wyojustin/DryBoxU1/stl/latch_saddle_qty=2.stl

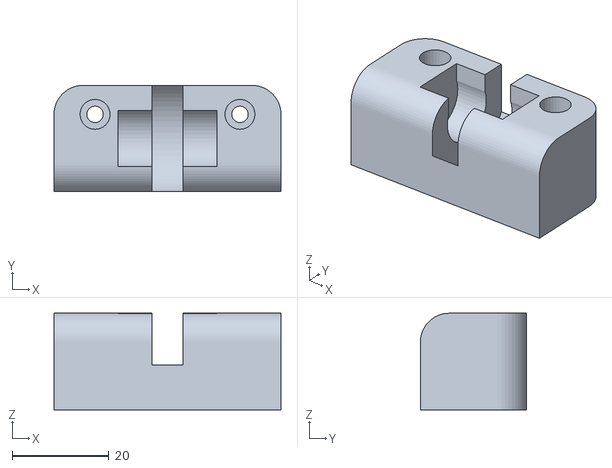
[picture p9: CAD file, 2026-11-11]
stl/latch_saddle_qty=2.stl
47.0 x 22.0 x 20.0
