wyojustin/DryBoxU1/stl/bar_end_cap_qty=2.stl

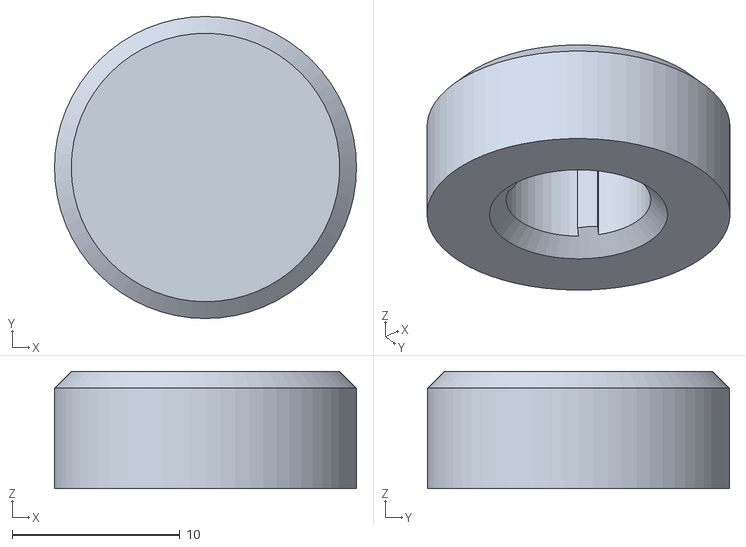
[picture p10: CAD file, 2026-11-11]
stl/bar_end_cap_qty=2.stl
18.0 x 18.0 x 7.00
