wyojustin/DryBoxU1/stl/door_catch_qty=2.stl

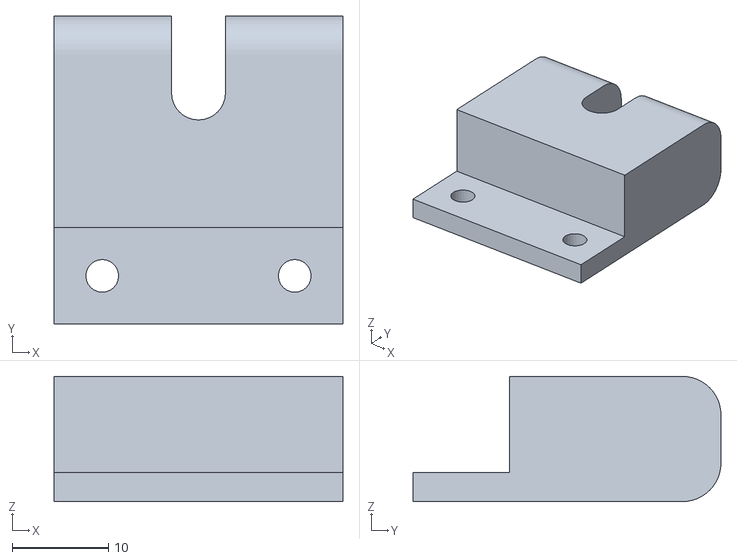
[picture p11: CAD file, 2026-11-11]
stl/door_catch_qty=2.stl
30.0 x 32.0 x 13.0
