wyojustin/DryBoxU1/stl/roller_qty=8.stl

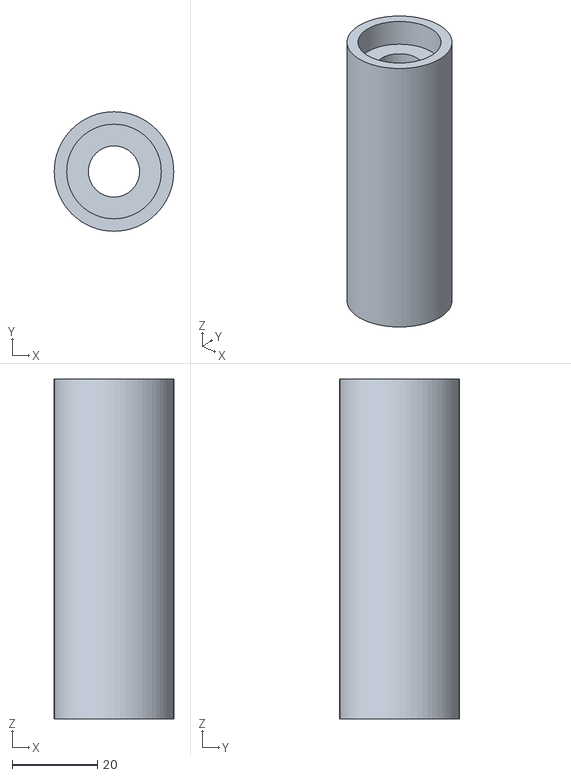
[picture p12: CAD file, 2026-11-07]
stl/roller_qty=8.stl
28.0 x 28.0 x 79.6
