wyojustin/DryBoxU1/stl/hinge_ring_qty=2.stl

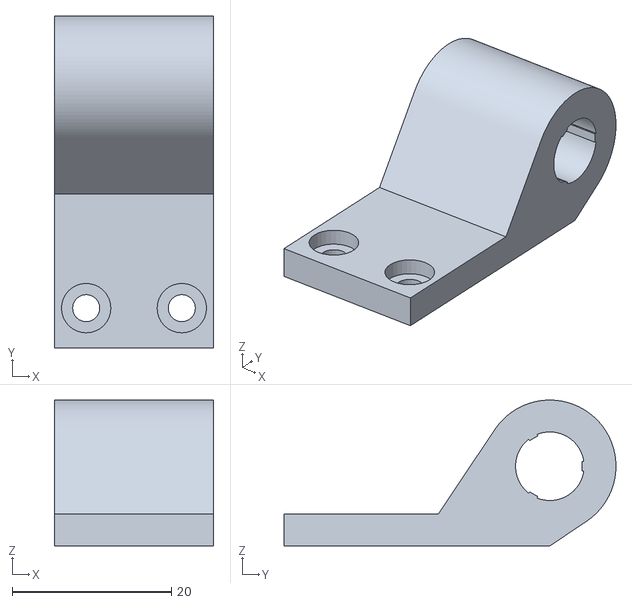
[picture p13: CAD file, 2026-11-07]
stl/hinge_ring_qty=2.stl
20.0 x 41.6 x 18.3
