wyojustin/DryBoxU1/stl/rod_end_cap_qty=8.stl

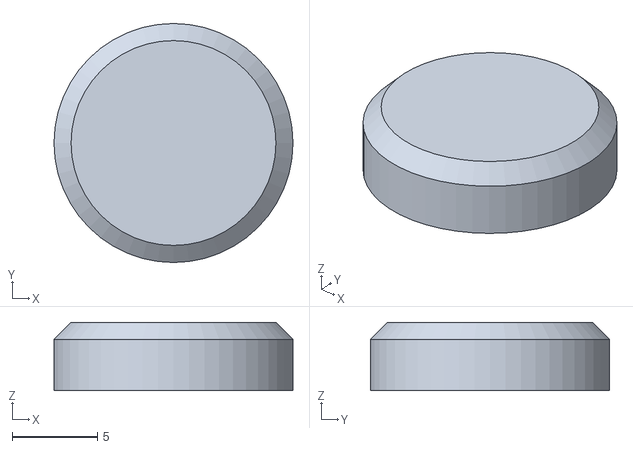
[picture p14: CAD file, 2026-11-07]
stl/rod_end_cap_qty=8.stl
14.0 x 14.0 x 4.00
