wyojustin/DryBoxU1/stl/2026-11-03_swing_latch_saddle.stl

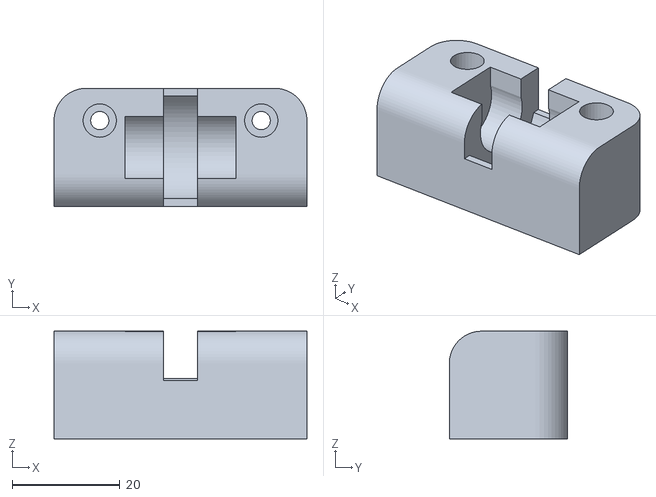
[picture p15: CAD file, 2026-11-07]
stl/2026-11-03_swing_latch_saddle.stl
47.0 x 22.0 x 20.0
