wyojustin/DryBoxU1/stl/latch_barrel_qty=2.stl

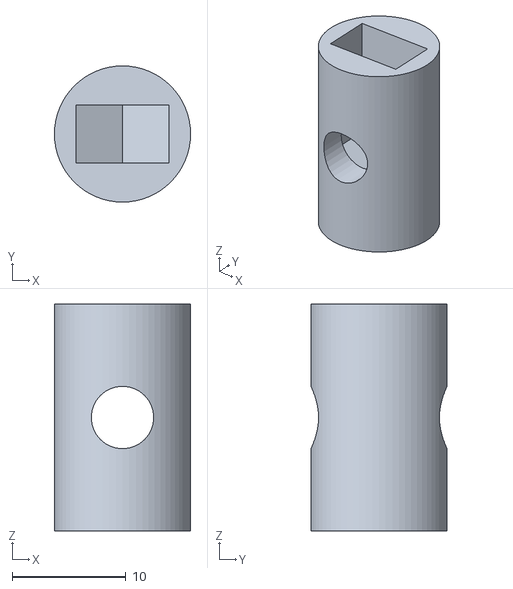
[picture p16: CAD file, 2026-11-07]
stl/latch_barrel_qty=2.stl
12.0 x 12.0 x 20.0
