wyojustin/DryBoxU1/stl/door_handle_qty=1.stl

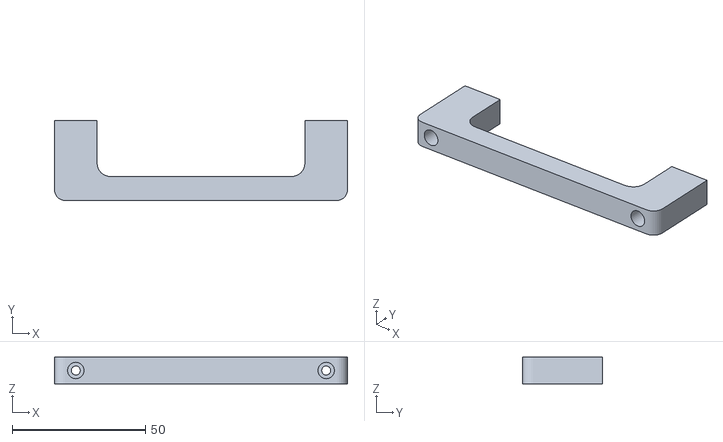
[picture p17: CAD file, 2026-11-07]
stl/door_handle_qty=1.stl
110.0 x 30.0 x 10.0
