wyojustin/DryBoxU1/stl/corner_bracket_qty=4.stl

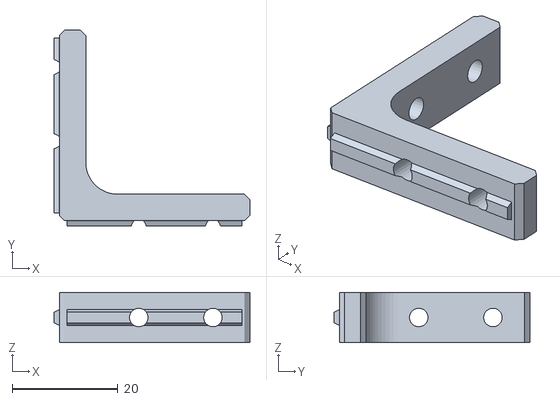
[picture p18: CAD file, 2026-11-07]
stl/corner_bracket_qty=4.stl
37.0 x 37.0 x 9.50
