wyojustin/DryBoxU1/stl/hinge_loop_qty=2.stl

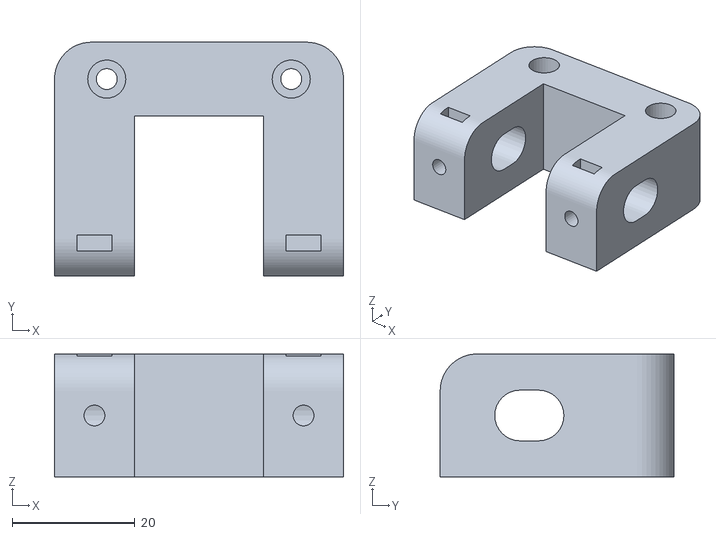
[picture p19: CAD file, 2026-11-07]
stl/hinge_loop_qty=2.stl
47.0 x 38.0 x 20.0
