wyojustin/DryBoxU1/stl/feeder_insert_qty=2.stl

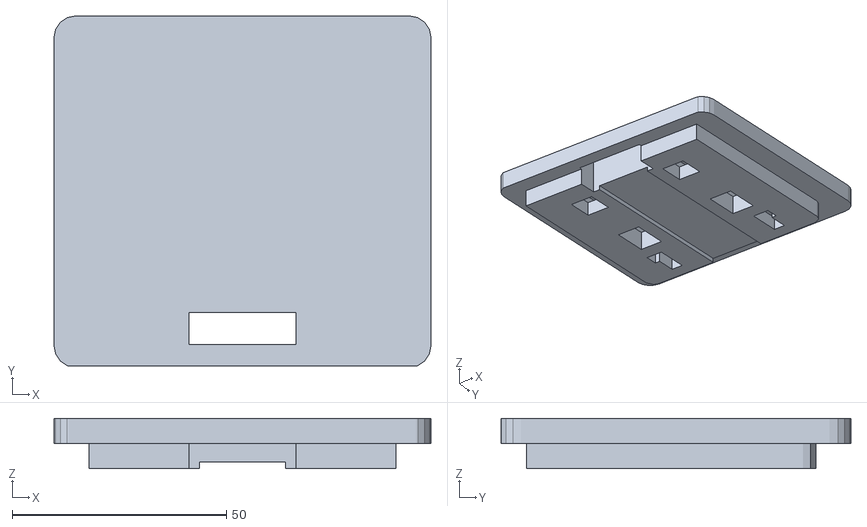
[picture p20: CAD file, 2026-11-07]
stl/feeder_insert_qty=2.stl
88.0 x 81.7 x 11.7
