wyojustin/DryBoxU1/stl/roller_washer_qty=16.stl

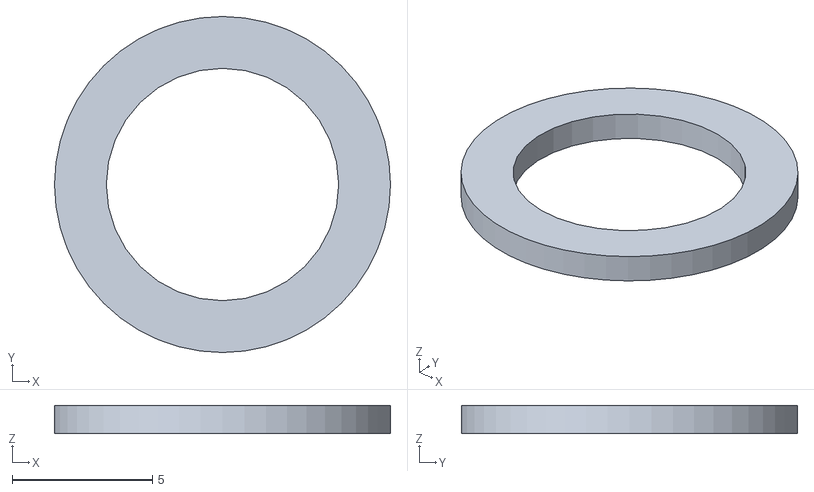
[picture p21: CAD file, 2026-11-07]
stl/roller_washer_qty=16.stl
12.0 x 12.0 x 1.00
