wyojustin/DryBoxU1/scad/2026-10-31_dry_box_bracket.scad

// 2026-10-31: inside corner bracket for the dry box's 1010 front frame. A 90 degree angle
// in each inside corner of the door opening: one leg on the horizontal member's inner face,
// one on the vertical's inner face, 2 M3 x 8 screws per leg into T-nuts in those slots
// (the outer slots carry the panel screws, the front face carries the foam seal).
// Symmetric, so all 4 corners take the same part. The bracket is 0.5 mm narrower than the
// extrusion depth: set it flush with the back face so it stays clear of the door and seal.
// Print on its side (the L profile on the bed): layers then run around the corner, and the
// screw holes print horizontal (small, they bridge fine). PLA, 0.2 mm, 4 walls, 40 %.
// Profile axes: x along the horizontal leg, y along the vertical leg, z across the
// extrusion depth. Units mm.

ext     = 10;      // 1010 extrusion width and depth
plate_t = 5.0;     // M3 x 8 reaches 8 - 5.0 = 3.0 past the face = tnut_tip in panels.scad
leg     = 36;      // leg length from the corner
w       = ext - 0.5;
screw_d = 3.5;     // M3 clearance
screw   = [15, 29];    // hole positions from the corner, both legs
fillet  = 6;       // inside fillet, kept clear of the nearest screw head (M3 head d 5.5)
edge_r  = 1;       // rounding on the leg ends and the outer corner
// alignment key: a rib down each leg's mounting face that drops into the slot opening
// (3.3 mm) and keeps the bracket centered and square. Tapered 3.0 -> 2.0 mm so it
// starts easily and its sideways overhang prints without support.
key_h   = 1.0;
key_w   = [3.0, 2.0];  // at the face, at the tip
key_end = 1.5;         // stop short of the leg end and of the rounded outer corner

module profile() {
    offset(r = edge_r) offset(delta = -edge_r) union() {
        square([leg, plate_t]);
        square([plate_t, leg]);
    }
    translate([plate_t, plate_t]) difference() {
        square(fillet);
        translate([fillet, fillet]) circle(r = fillet, $fn = 48);
    }
}

// key along x on the y = 0 face, protruding toward -y
module key() {
    hull() {
        translate([key_end, -0.01, (w - key_w[0]) / 2]) cube([leg - 2 * key_end, 0.01, key_w[0]]);
        translate([key_end, -key_h, (w - key_w[1]) / 2]) cube([leg - 2 * key_end, 0.01, key_w[1]]);
    }
}

difference() {
    union() {
        linear_extrude(w) profile();
        key();                                                 // horizontal leg
        multmatrix([[0, 1, 0, 0], [1, 0, 0, 0], [0, 0, 1, 0]]) key();   // vertical leg (x <-> y)
    }
    for (p = screw) {
        translate([p, -key_h - 1, w / 2]) rotate([-90, 0, 0]) cylinder(d = screw_d, h = plate_t + key_h + 2, $fn = 24);
        translate([-key_h - 1, p, w / 2]) rotate([0, 90, 0])  cylinder(d = screw_d, h = plate_t + key_h + 2, $fn = 24);
    }
}

echo(str("inside bracket ", leg, " x ", leg, " x ", w, " mm, plate ", plate_t,
         "; screws at ", screw, "; head clearance from fillet ",
         screw[0] - 5.5 / 2 - (plate_t + fillet), " mm"));
