wyojustin/DryBoxU1/scad/2026-11-04_saddle_view.scad

// 2026-11-04: the swing-latch saddle on its own (v3), for viewing. Source: 2026-11-03_swing_latch.scad.
use <2026-11-03_swing_latch.scad>
color([0.95, 0.55, 0.1]) saddle();
