wyojustin/DryBoxU1/(list of files, cad)

Other CAD files:
stl/2026-11-04_door_catch.stl
scad/2026-11-03_feeder_assembly_closeup.scad
scad/2026-11-04_loop_hook_profile.scad
