wyojustin/DryBoxU1/(commit log)

2026-11-07 DryBoxU1: design to date, before final cut sheets
    Shell panels and strips, interior sheet, spool holders, door mounts,
    swing latch, feeder insert v11, assembly with the SS6152 desiccant pan
    at assumed dimensions, hardware and cut lists, STLs and renders.
    Cut SVGs match the files staged on the Mac mini (2026-11-07).
    [2026-10-30_dry_box_concept.scad, 2026-10-30_dry_box_cradle.scad, 2026-10-30_dry_box_cradle.stl, 2026-10-30_dry_box_panels.scad, 2026-10-30_dry_box_roller.stl, 2026-10-30_dry_box_sheets.scad, 2026-10-30_fit_gauge.scad, 2026-10-30_fit_gauge.stl]
2026-11-11 Close out shell, rod and 1010 cuts; full cut checklist; STLs named by part and quantity
    Shell (stock measured 603 x 910; the laser takes 530, so sheets are ripped by hand):
    - Back panel owns the 4 back corner cubes (they hung on 0.25 pinches in top/bottom).
    - Gland hole 19.8 (PG13.5 thread measured 19.6).
    - Strips: B, C ripped at 450, A split in the middle; strips 1, 2 gap 3, centered on 910.
    Spool holders and rods:
    - Rods bottom in their end caps before a cap reaches the acrylic: holder rods 189, door bar 381.
    - Base strips 35 tall at the plate ends (the old 12 mm strips overlapped the rollers), end tabs in
    open-ended slots in the outer plates, half-lap at the middle plate; plates 176.
    -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
    [2026-10-30_dry_box_cradle.stl, 2026-10-30_dry_box_panels.scad, 2026-10-30_dry_box_roller.stl, 2026-10-30_dry_box_sheets.scad, 2026-10-30_fit_gauge.stl, 2026-11-02_feeder_insert.stl, 2026-11-02_feeder_insert_v2.stl, 2026-11-02_feeder_insert_v3.stl]
2026-11-11 Images: keep only the README's pictures, in images/
    Moved the 8 images the README shows into images/ and pointed the README at them. Removed every
    other PNG (the dated design log in the top folder and renders/); they stay in the git history.
    The cut checklist links its figures at commit 774f584.
    [2026-10-30_dry_box_sheets.scad]
2026-11-11 README renders from the latest design
    Re-rendered all 8 README views (same cameras) from the current model: floor rail gone, holders with
    35 mm tabbed strips and 189 rods, caps standing off the plates and loops, saddle v10, rounded catch,
    back panel owning the corner cubes.
2026-11-11 Move all .scad files into scad/
    All 30 files moved with git mv; use<> paths are unchanged (same folder), STL imports now read
    ../stl/. Every file was run from scad/ with OpenSCAD 2021.01 (preview): no warnings or errors.
    README file table, folder notes and the cut checklist point at scad/.
    [2026-10-30_dry_box_concept.scad, 2026-10-30_dry_box_cradle.scad, 2026-10-30_dry_box_panels.scad, 2026-10-30_dry_box_sheets.scad, 2026-10-30_fit_gauge.scad, 2026-10-30_kerf_coupon.scad, 2026-10-31_dry_box_bracket.scad, 2026-11-02_feeder_hanger_concept.scad]
2026-11-11 Rename cut SVGs to <part>_qty=<n>.svg, update checklist links
    qty is the number of times to run the file. panel_* files duplicate the
    strip parts; cut the strips.
